sbgisen/MINI4/MINI_VESC_PCBGoGo.xlsx

品名 Name | 部品番号 Designator | 個数 Quantity | 値 Value | パッケージ Package | 説明 Description | 部品メーカー Manufacturer | 部品メーカーの品番 Manufacturer Part Number | 代替可否
コンデンサ | C1,C21,C25 | 3 | 10u | 2012 |  | Murata | GRM21BR61H106KE43K | 可
コンデンサ | C2,C3,C4,C5,C6,C7 | 6 | 1u | 1005 |  | Murata | GRM155R61H105KE05D | 可
コンデンサ | C8,C12,C13,C19,C20,C28,C32 | 7 | 100n | 0603 |  | Murata | GRM033R6YA104KE14J | 可
コンデンサ | C9,C10,C11,C17,C18,C24,C77,C86,C87,C88,C89,C90 | 12 | 2u2 | 1005 |  | Murata | GRM155R6YA225KE11D | 可
コンデンサ | C14,C15,C16 | 3 | 4n7 | 0603 |  | Murata | GRM033R71E472KE14J | 可
コンデンサ | C23 | 1 | 220n | 0603 |  | Murata | GRM033R61E224KE01D | 可
コンデンサ | C30,C31 | 2 | 10p | 0603 |  | Murata | GCM0335C1H100FA16J | 可
ダイオード | D1 | 1 | PMEG6020AELR | SOD-123 |  | Nexperia | PMEG6020AELR | 不可
LED | D3 | 1 | LED | 1005 |  | ROHM Semiconductor | SML-P11MTT86R | 不可
LED | D4 | 1 | LED | 1005 |  | ROHM Semiconductor | SML-P11UTT86R | 不可
コネクタ | J1 | 1 | HallSensor | 53047-0510 |  | Molex | 53047-0510 | 不可
コネクタ | J3 | 1 | CAN1 | S4B-PH-SM4-TB |  | JST | S4B-PH-SM4-TB | 不可
コネクタ | J4 | 1 | CAN2 | S4B-PH-SM4-TB |  | JST | S4B-PH-SM4-TB | 不可
コネクタ | J5 | 1 | Encoder | 53047-0310 |  | Molex | 53047-0310 | 不可
インダクタ | L1 | 1 | 74438335220 | 3030 |  | Wurth Elektronik | 74438335220 | 不可
抵抗 | R1,R2,R3 | 3 | 5m | 1608 |  | Panasonic | ERJ-3LWFR005V | 不可
抵抗 | R4,R12,R14 | 3 | 39k | 0603 |  | Vishay | CRCW020139K0JNED | 可
抵抗 | R5,R13,R15,R17 | 4 | 2k2 | 0603 |  | Vishay | CRCW02012K20FKED | 可
抵抗 | R6,R7,R8 | 3 | 4.7 | 0603 |  | Vishay | CRCW02014R70FXED | 可
抵抗 | R9,R28,R29 | 3 | 220R | 0603 |  | Vishay | CRCW0201220RFNED | 可
抵抗 | R16 | 1 | 25k5 | 0603 |  | Vishay | CRCW020125K5FNED | 可
抵抗 | R18,R19,R20 | 3 | 100R | 0603 |  | Vishay | CRCW0201100RFNED | 可
抵抗 | R21,R31 | 2 | 10k | 0603 |  | Vishay | CRCW020110K0FNED | 可
抵抗 | R22 | 1 | 54k9 | 0603 |  | Vishay | CRCW020154K9FNED | 可
抵抗 | R32 | 1 | 10k | 0603 |  | Vishay | CRCW020110K0FNED | 可
抵抗 | R33 | 1 | 100k | 0603 |  | Vishay | CRCW0201100KFNED | 可
ゲートドライバ | U1,U2,U3 | 3 | MP1909 | SOT583 |  | Monolithic Power Systems (MPS) | MP1909GTL-P | 不可
電流センサ | U4,U5,U6 | 3 | AD8417 | 8-Lead MSOP |  | Analog Devices Inc. | AD8417BRMZ | 不可
マイコン | U7 | 1 | STM32F405RGT6 | LQFP-64 |  | STMicroelectronics | STM32F405RGT6 | 不可
DCDCコンバータ | U8 | 1 | LMR16006YDDCT | SOT-23-6 |  | Texas Instruments | LMR16006YDDCT | 不可
降圧レギュレータ | U9,U10 | 2 | MCP1700 | SOT-23 |  | Microchip | MCP1700T-3302E/TT | 不可
MOSFET | U11,U12,U13 | 3 | UT6K3TCR | DFN2020-8D |  | ROHM Semiconductor | UT6K3TCR | 不可
CANトランシーバ | U14 | 1 | TJA1051TK-3 | DFN-8-1EP |  | NXP | TJA1051TK/3,118 | 不可
水晶発振子 | Y1 | 1 | Crystal_GND24 | 3225-4Pin |  | ABRACON | FC3BAEBDI8.0-T1 | 不可
