sbgisen/MINI4/HP8MA2TB1/HP8MA2TB1.stp

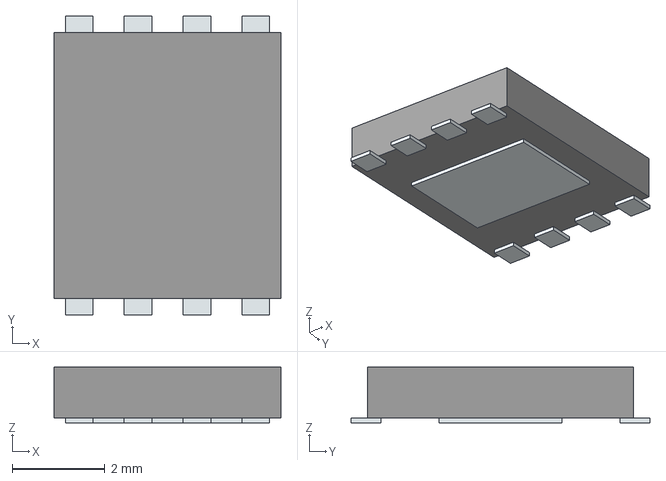
[picture p1: CAD file, 2024-05-01]
HP8MA2TB1/HP8MA2TB1.stp
4.90 x 6.45 x 1.20 mm
Pins
