sbgisen/MINI4/mini_vesc_inductor_hole.step

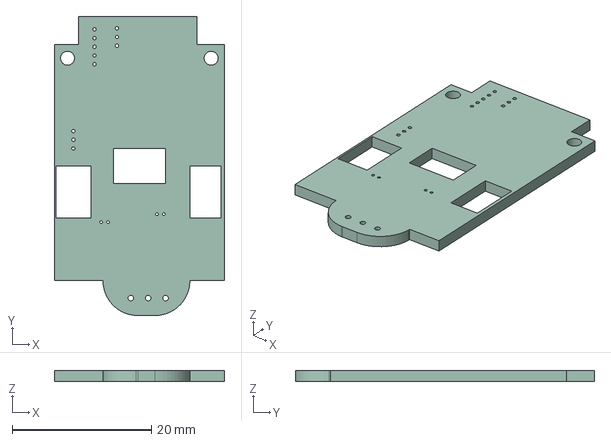
[picture p3: CAD file, 2025-03-07]
mini_vesc_inductor_hole.step
24.5 x 43.0 x 1.60 mm
