sbgisen/MINI4/bcu_output.pdf

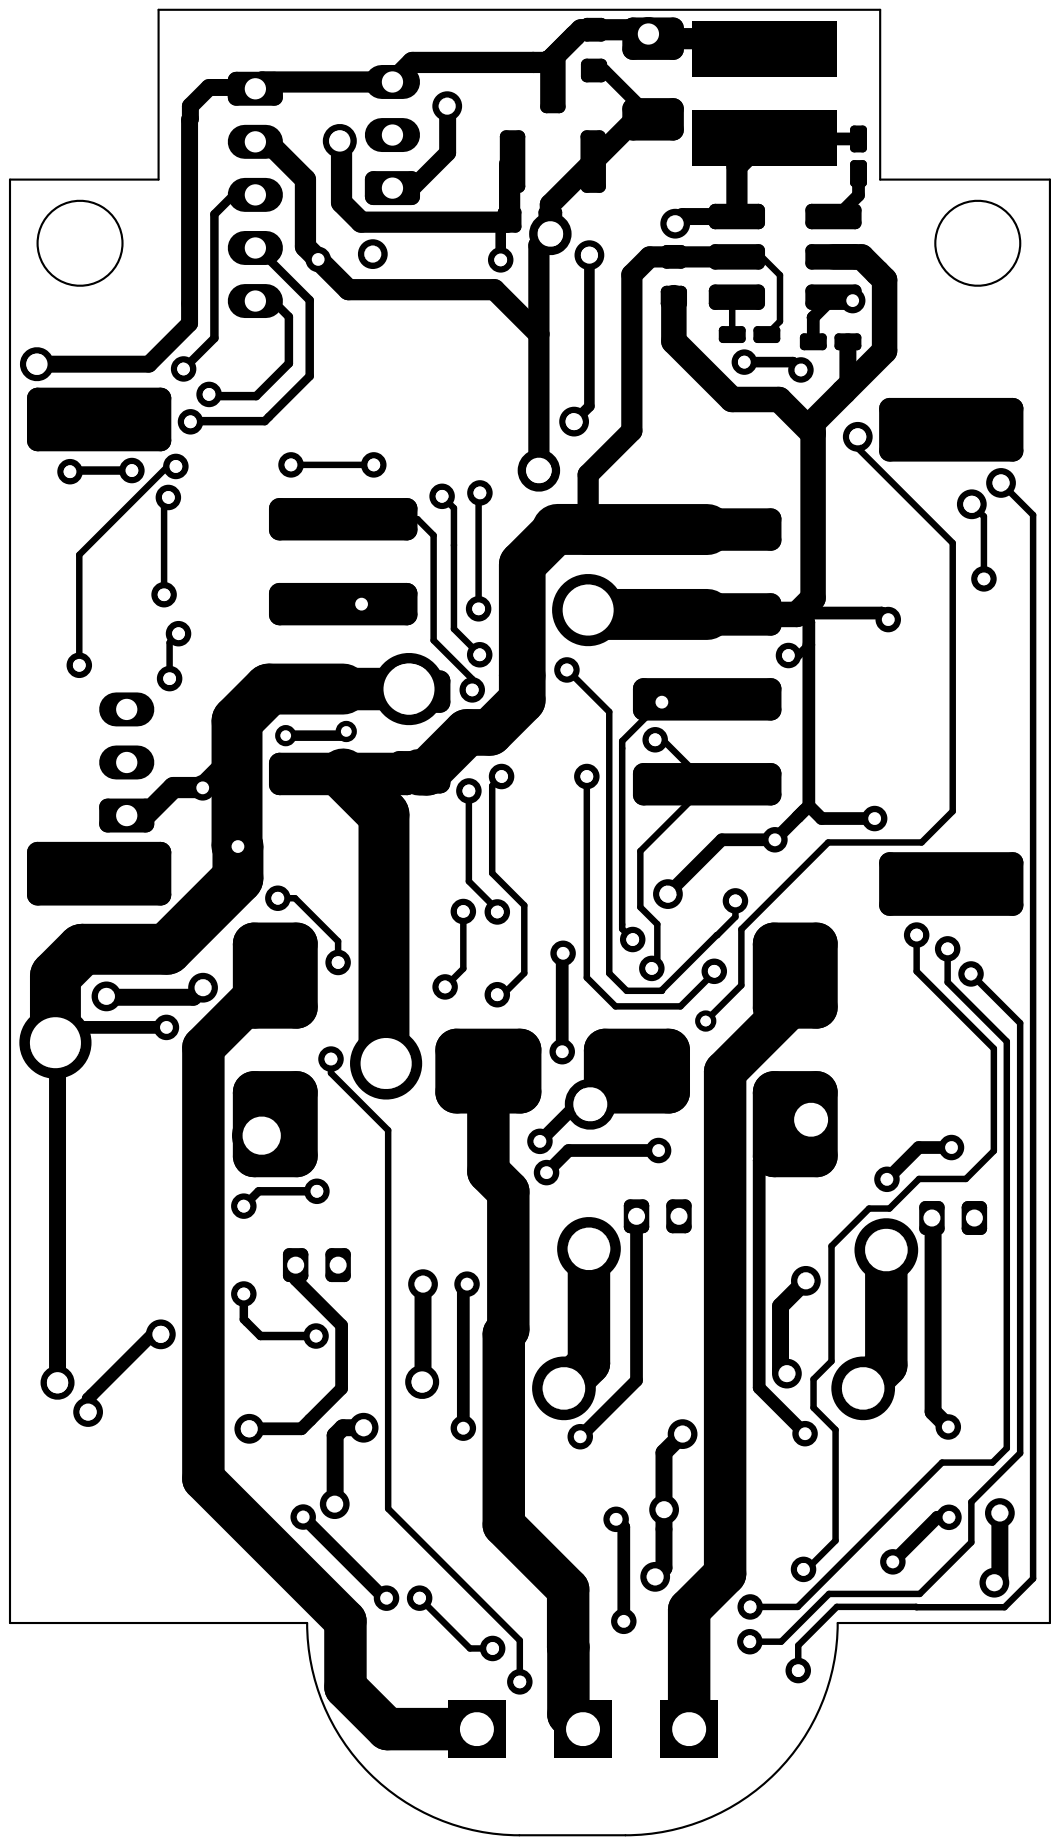
[picture p4: page 1]
