sbgisen/MINI4/fcu_output.pdf

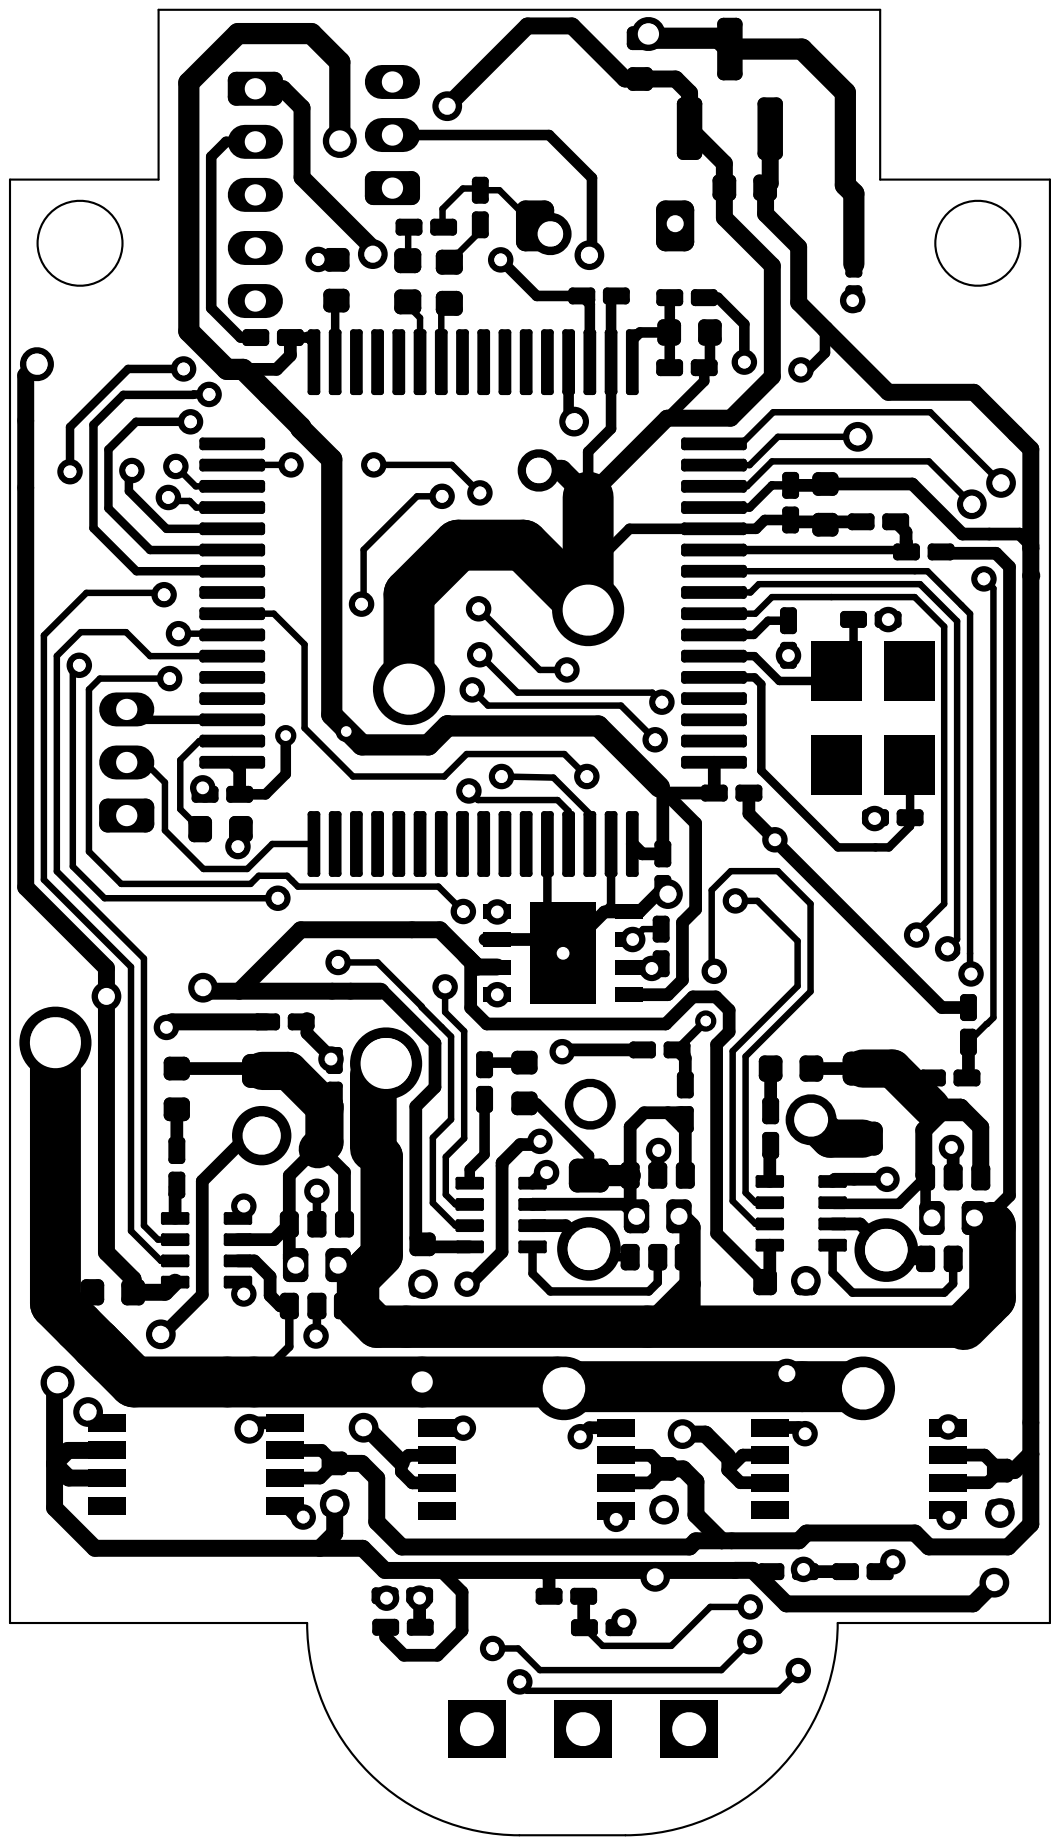
[picture p5: page 1]
