sbgisen/MINI4/sch_output.pdf

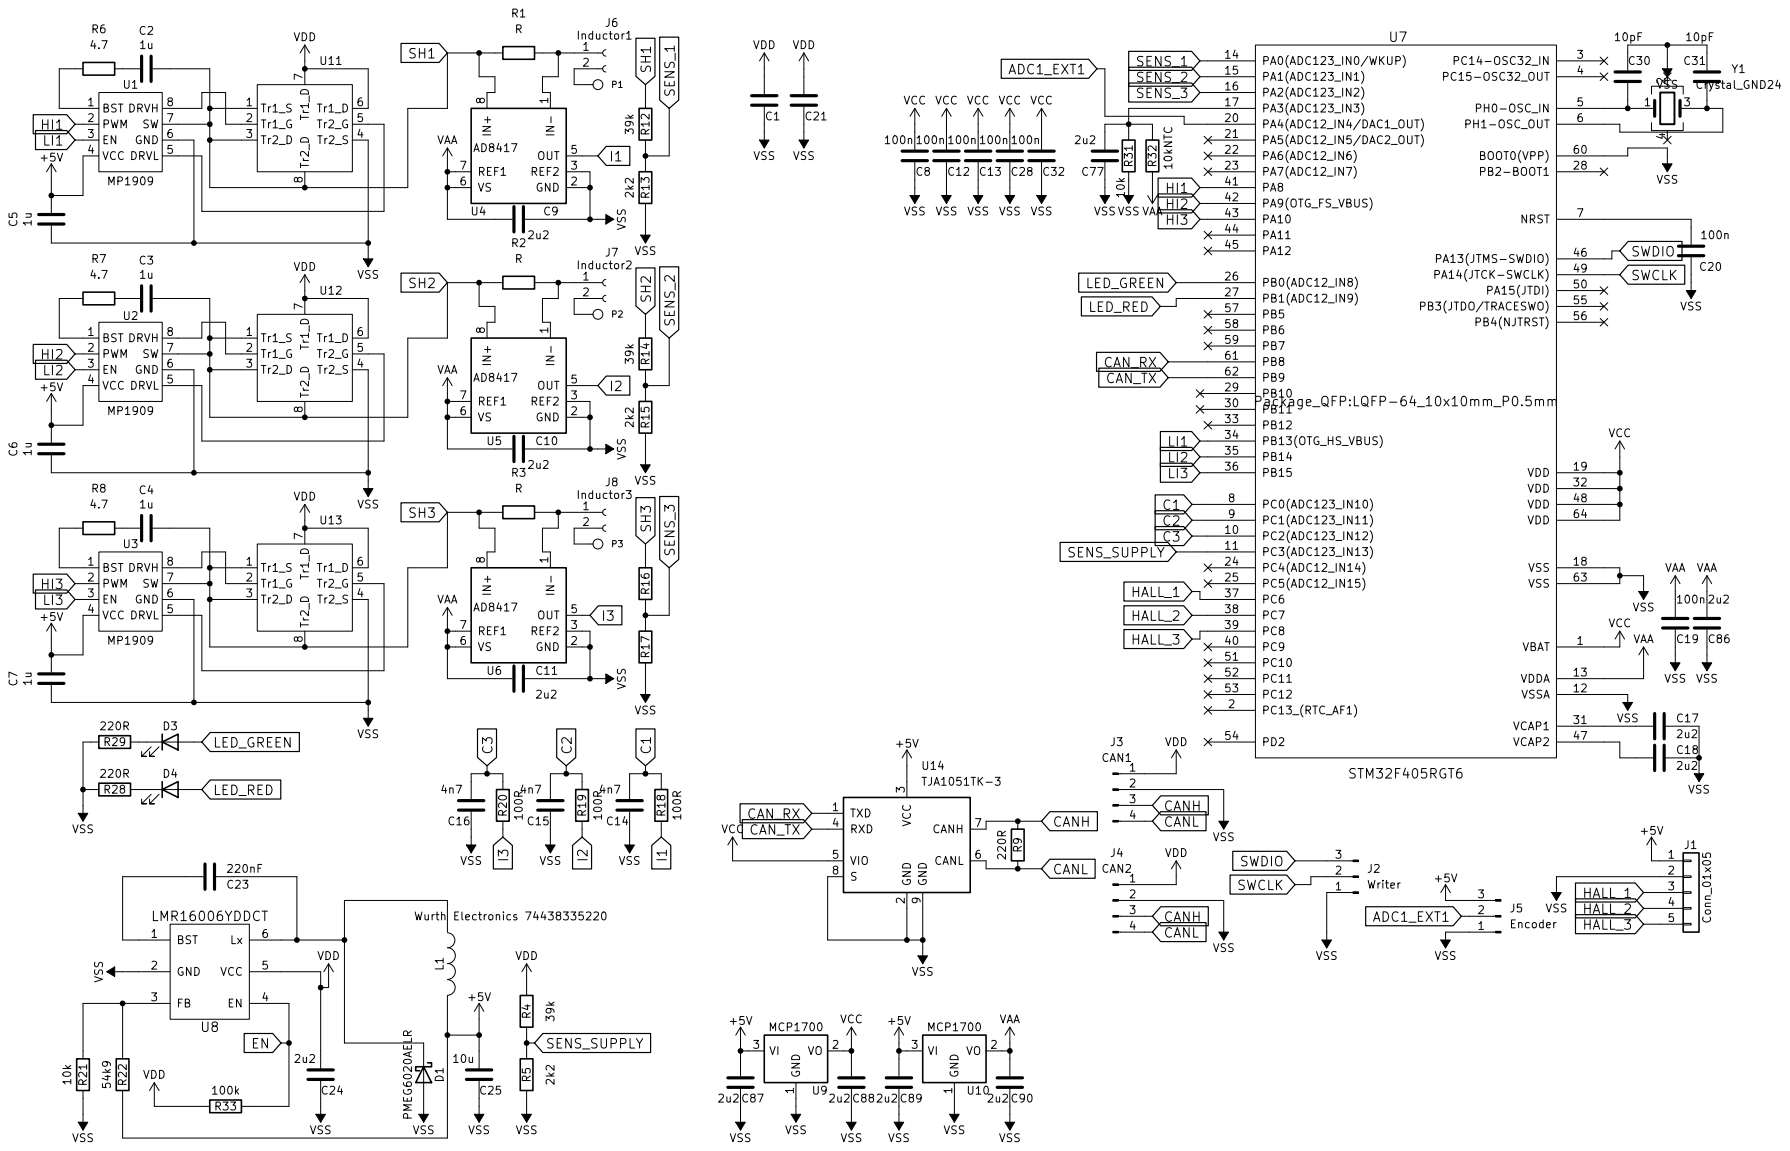
[picture p6: page 1]
