sbgisen/MINI4/(commit log)

2022-12-15 Update project to KiCAD 6.
    [MINI VESC.kicad_pcb, MINI VESC.kicad_sch]
2024-02-01 Saved from kicad7
    [MINI VESC.kicad_pcb, MINI VESC.kicad_sch]
2025-02-07 feat: designed mini vesc for feetech
    [MINI VESC.kicad_pcb, MINI VESC.kicad_sch, MINI VESC.step]
2025-03-07 chore: add sch and pcb pdf files
    [MINI VESC-B.Cu.gbl, MINI VESC-B.Mask.gbs, MINI VESC-B.Paste.gbp, MINI VESC-B.SilkS.gbo, MINI VESC-B_Cu.gbl, MINI VESC-B_Mask.gbs, MINI VESC-B_Silkscreen.gbo, MINI VESC-Edge.Cuts.gm1]
2025-04-18 feat: add shunt resistor value 5m ohm
    [MINI VESC.kicad_sch]
2025-05-20 fix: fix CAN TxD and RxD
    [MINI VESC.kicad_pcb, MINI VESC.kicad_sch]
2025-05-20 add: add uart pins
    [MINI VESC.kicad_pcb, MINI VESC.kicad_sch]
2025-05-27 add: add part list
    [MINI VESC-B_Cu.gbl, MINI VESC-B_Mask.gbs, MINI VESC-B_Silkscreen.gbo, MINI VESC-Edge_Cuts.gm1, MINI VESC-F_Cu.gtl, MINI VESC-F_Mask.gts, MINI VESC-F_Silkscreen.gto, MINI VESC.drl]
2025-06-03 add: part list for pcbgogo
    [MINI VESC.csv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]
2025-06-06 newest commit
    [MINI_VESC_PCBGoGo.xlsx]
2026-02-06 chore: fix the label of usb dp/dm connector
    [MINI VESC.kicad_pcb, MINI VESC.kicad_sch]
2026-02-13 fix: fix MINI_VESC_PCBGoGo.xlsx(BOM)
    [MINI_VESC_PCBGoGo.xlsx]
2026-02-13 add: add pos files
    [MINI VESC-bottom-pos.csv, MINI VESC-top-pos.csv]
2026-03-24 fix: fix BOM file (LED color)
    [MINI_VESC_PCBGoGo.xlsx]
